maxgerhardt/ac_sc_grinder/doc/data/r_l_calibration_100_percents.ods

time, sec | Current*50 | Voltage, V | Current, A | P | I^2 | di_dt | R, Ohm | L, H | filtered L, H
0 | 0,6401062 | 0,159484863 | 0,012802124 | 0,002041744992249 | 0,000163894378911 | 0 | 89,2460660263269 |  | 0,036699034974452
5,59440559440559E-05 | 0,64086914 | 5,31513977 | 0,0128173828 | 0,070167926059843 | 0,000328179680753 | 0,272751049999985 |  | 15,2932088743443
0,000111888111888 | 0,801086425 | 12,0840454 | 0,0160217285 | 0,263775220640317 | 0,000584875464881 | 57,2776793875 |  | 0,186009092448641
0,000167832167832 | 0,800323485 | 17,7089539 | 0,0160064697 | 0,547233054659364 | 0,000841082537138 | -0,272751050000016 |  | -59,6897406932235
0,000223776223776 | 0,96054077 | 22,3800201 | 0,0192108154 | 0,977171489448753 | 0,001210137965471 | 57,2776793875 |  | 0,360795524912659
0,00027972027972 | 1,041412355 | 28,5171204 | 0,0208282471 | 1,5711331197204 | 0,001643953842729 | 28,9115916375 |  | 0,92206204412224
0,000335664335664 | 1,28250122 | 33,1881866 | 0,0256500244 | 2,42241091580216 | 0,00230187759445 | 86,1892692375 |  | 0,358501970166106
0,000391608391608 | 1,52282715 | 38,0218048 | 0,030456543 | 3,58042364863096 | 0,003229478605961 | 85,916519975 |  | 0,410906751841916
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
