maxgerhardt/ac_sc_grinder/doc/data/r_l_calibration_10_percents.ods

t, sec | Voltage, V | Current*100 | Current, A | di_dt | P | I^2 | R, Ohm | L, H
0 | 0,318969727 | 1,44042969 | 0,0144042969 | 0 |  |  | 139,390035628508 | 0,151006626140444
5,59440559440559E-05 | 6,12176514 | 1,28173828 | 0,0128173828 | -28,3660895375
0,000111888111888 | 13,2096405 | 1,28173828 | 0,0128173828 | 0
0,000167832167832 | 19,4816895 | 1,2802124 | 0,012802124 | -0,272751049999985
0,000223776223776 | 25,7782745 | 1,44195557 | 0,0144195557 | 28,9115916375
0,00027972027972 | 32,706665 | 1,44195557 | 0,0144195557 | 0
0,000335664335664 | 38,1843567 | 1,44195557 | 0,0144195557 | 0
0,000391608391608 | 43,9840851 | 1,44195557 | 0,0144195557 | 0
0,000447552447552 | 49,6243286 | 1,28173828 | 0,0128173828 | -28,6388405875
0,000503496503497 | 55,2247009 | 1,2802124 | 0,012802124 | -0,272751049999985
0,000559440559441 | 60,0981903 | 1,28173828 | 0,0128173828 | 0,272751049999985
0,000615384615385 | 64,7692566 | 1,121521 | 0,01121521 | -28,6388388
0,000671328671329 | 68,912796 | 1,2802124 | 0,012802124 | 28,36608775
0,000727272727273 | 72,8263092 | 0,961303711 | 0,00961303711 | -57,00492815875
0,000783216783217 | 77,6599274 | 1,121521 | 0,01121521 | 28,63884040875
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
