maxgerhardt/ac_sc_grinder/doc/data/r_l_calibration_15_percents.ods

t, sec | Voltage, V | Current*100 | Current, A | di_dt | P | I^2 | R, Ohm | L, H
0 | 2,41680908 | 1,28173828 | 0,0128173828 | 0 |  |  | 121,042104217508 | 0,146960963566436
5,59440559440559E-05 | 8,54470825 | 1,121521 | 0,01121521 | -28,6388388
0,000111888111888 | 14,1880188 | 1,44348145 | 0,0144348145 | 57,5504304375
0,000167832167832 | 19,8159943 | 1,28173828 | 0,0128173828 | -28,9115916375
0,000223776223776 | 25,312088 | 1,28326416 | 0,0128326416 | 0,272751049999985
0,00027972027972 | 31,4369202 | 1,28326416 | 0,0128326416 | 0
0,000335664335664 | 36,2736053 | 1,28326416 | 0,0128326416 | 0
0,000391608391608 | 40,7637177 | 1,28173828 | 0,0128173828 | -0,272751049999985
0,000447552447552 | 45,7874908 | 1,121521 | 0,01121521 | -28,6388388
0,000503496503497 | 50,9124756 | 0,961303711 | 0,00961303711 | -28,63884040875
0,000559440559441 | 54,9394684 | 1,121521 | 0,01121521 | 28,63884040875
0,000615384615385 | 59,4510498 | 0,961303711 | 0,00961303711 | -28,63884040875
0,000671328671329 | 63,361496 | 0,961303711 | 0,00961303711 | 0
0,000727272727273 | 67,5081024 | 0,961303711 | 0,00961303711 | 0
0,000783216783217 | 72,5502777 | 1,121521 | 0,01121521 | 28,63884040875
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
