maxgerhardt/ac_sc_grinder/(commit log)

2018-07-09 add classes Sensors, Triac; block diagram changed, moved to README.md; add function zerocross; speedController tick on voltage zero cross
2018-07-09 bulk fixes after review
    [eeprom_float.h, main.cpp, schema.yml, sensors.h, speed_controller.h, triac_driver.h]
2018-07-09 Move ADC normalization into Sensors & code cleanup
2018-07-09 Move clamping logic to outer function
2018-07-09 Keep sensors.prev_voltage private
2018-07-10 add STM32CubeMX project file /src/cube/ac_sc_grinder.ioc
2018-07-13 fix the logic of PIDs operation
    [speed_controller.h]
2018-07-13 fix default motor resistance value
2018-07-13 add missing counters reset
    [sensors.h]
2018-07-14 add README for STM32CubeMX project
2018-07-14 add ADC calibration
2018-07-17 Note about ADC calibration
2018-07-17 Fixes of prev improvements
    [main.cpp, sensors.h]
2018-07-18 Added fixed point math stub
    [fix16_math.h, main.cpp, sensors.h]
2018-07-18 Added "sinusizer" fixed point stub
    [fix16_math.h, main.cpp]
2018-07-19 Rewrite to fixed point math
    [main.cpp, sensors.h, speed_controller.h, triac_driver.h]
2018-07-19 Assorted fixes & code cleanup
    [fix16_math.h, main.cpp, sensors.h, speed_controller.h, triac_driver.h]
2018-07-19 Remove fix_ prefix from var names
    [main.cpp, sensors.h, speed_controller.h, triac_driver.h]
2018-07-20 Fix adc math
2018-07-20 Implement sinusizer via LUT + related fixes
    [fix16_math.h, main.cpp, triac_driver.h]
2018-07-21 cube -> stm32cubemx
2018-07-21 src/stm32cubemx -> lib/stm32cubemx_init
2018-07-21 fix power calculation
2018-07-21 fix triac driver logic
    [app.cpp, sensors.h, triac_driver.h]
2018-07-21 speed controller tick freq 40 Hz
2018-07-24 Switch to libfixmath use
2018-07-24 update STM32CubeMX config
2018-07-30 Buffer ADC data for advanced filtering
2018-07-31 Additional recursive mean filter for knob input
2018-08-01 Implement truncated mean filtering
2018-08-01 Improve pid frequency definition
2018-08-02 trunc mean: drop old implementation & increase filter len 4 -> 8
2018-08-03 fix timer interrupt priority
2018-08-05 Docs: add power terminals to BOM info
2018-08-05 add missing counter increment and sum reset
    [sensors.h]
2018-08-07 sync data procession with ADC
2018-08-07 disable timer in CubeMX config
2018-08-07 add triac firing points correction
    [triac_driver.h]
2018-08-09 Docs: add filtering cap info
2018-08-14 Added calibrator stub
2018-08-19 Push triac state to sensors module
2018-08-19 Move calibrator code to separate file
2018-08-20 Replace asm hack with volatile
    [app.cpp]
2018-08-20 Fix triac off state forwarding
    [triac_driver.h]
2018-08-21 docs update
    [voltage_and_current.ods, voltage_current_speed.ods]
2018-08-21 Drop power sensor - not used anymore
2018-08-21 update PID parameters
2018-08-22 Split calibrator switch to smaller fns
2018-08-23 Revert "Split calibrator switch to smaller fns"
    This reverts commit 28a19a99b2eec1c187cdfc31c39461e60d925d87.
    [calibrator.h]
2018-08-23 Split calibrator to nested FSM-s
2018-08-23 Add speed scale calibration
2018-08-24 fix pid_limiter out value
    [speed_controller.h]
2018-08-24 median filter in speed calculator
2018-08-24 Added R/L calibration stub
2018-08-24 Drop triac phase corrections logic and add safety cutoff near zero point
    [triac_driver.h]
2018-08-24 Add missed prev_voltage update
    [triac_driver.h]
2018-08-24 add RL calibration description to doc
2018-08-25 Add missed flash unlock/lock on write
    [eeprom_float.h]
2018-08-25 fix speed calibration
2018-08-25 reduce delta in speed calibration
2018-08-25 Add zero cross output to sensors module
2018-08-25 More close connect sensors <-> triacDriver
2018-08-26 Refactor RL calibrator
2018-08-26 Refactor speed calibrator
2018-08-26 calibrate RL at 10% voltage
2018-08-26 Add R/L calibration data
    [r_l_calibration_100_percents.ods, r_l_calibration_10_percents.ods, r_l_calibration_15_percents.ods]
2018-08-26 Update calibration docs & config defaults
2018-09-02 Updated data files
    [rpms_vs_volts_idling.ods, speed_calculated.ods, voltage_current_speed.ods]
2018-09-07 Clamp minimal speed from bottom
2018-09-11 Add current offset compensation and power thresold in speed math
2018-09-11 Fix speed stability check
    [calibrator_speed_scale.h]
2018-09-12 Fix power treshold check
    [sensors.h]
2018-09-12 Add quick skip for zero speed
    [calibrator_speed_scale.h]
2018-09-13 calibrate R with maximum setpoint
2018-09-16 Clamp possible overflow at high speed
2018-09-22 Folder rename: fix16_math -> math
    [calibrator.h, calibrator_speed.h, calibrator_static.h, calibrator_wait_knob_dial.h, fix16_math.h, sensors.h, speed_controller.h]
2018-09-28 Make calibration setpoints values human readable
